knickers/planetary-extruder-visualizer/(commit log)

2020-02-27 Add the source code
    [planetary-gear.scad]
2020-02-28 Fine tune mounts and default parameters
    [planetary-gear.scad]
2020-07-10 More tolerance for less gear binding
    [planetary-gear.scad]
